evelynvaldezz/CODE-RED-controllers-sensors-portfolio/hardware/soldering_1.jpg

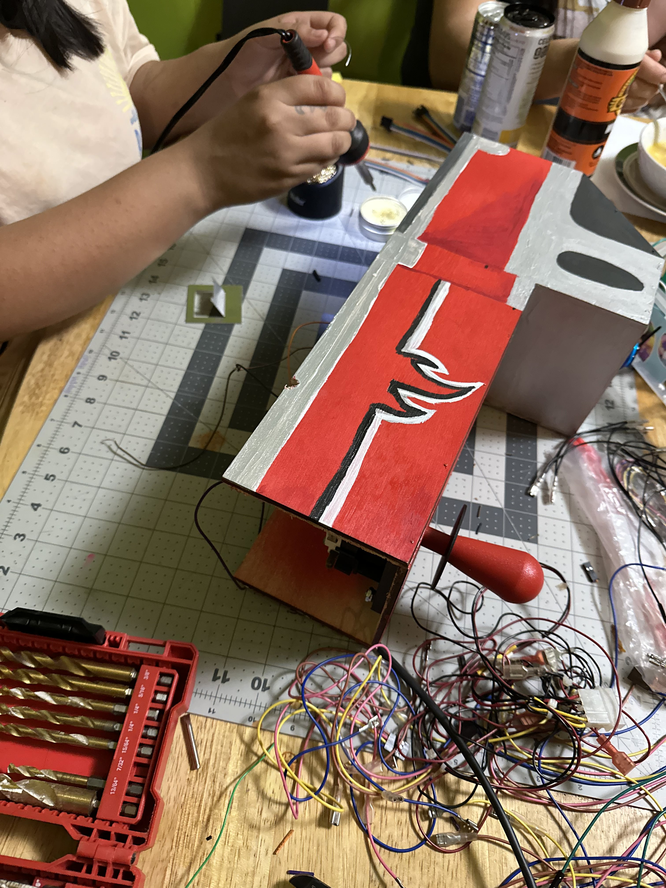
hardware/soldering_1.jpg
