evelynvaldezz/CODE-RED-controllers-sensors-portfolio/hardware/first_joystick_button_wire.PNG

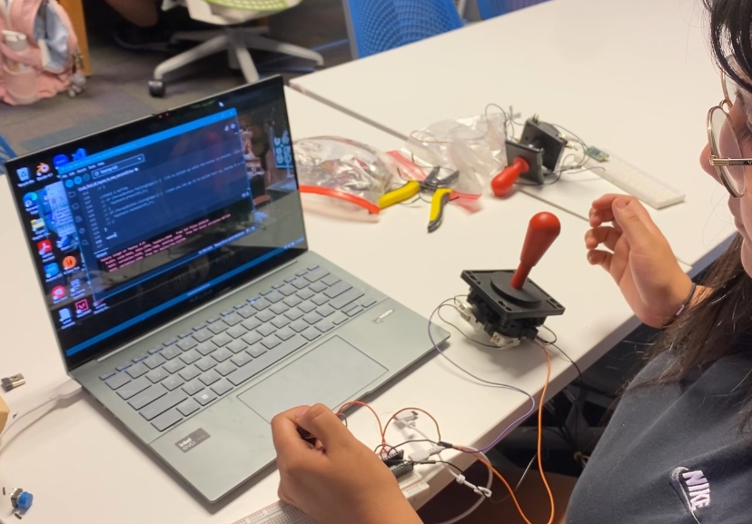
hardware/first_joystick_button_wire.PNG
