evelynvaldezz/CODE-RED-controllers-sensors-portfolio/concept/hardware_experience_concept.PNG

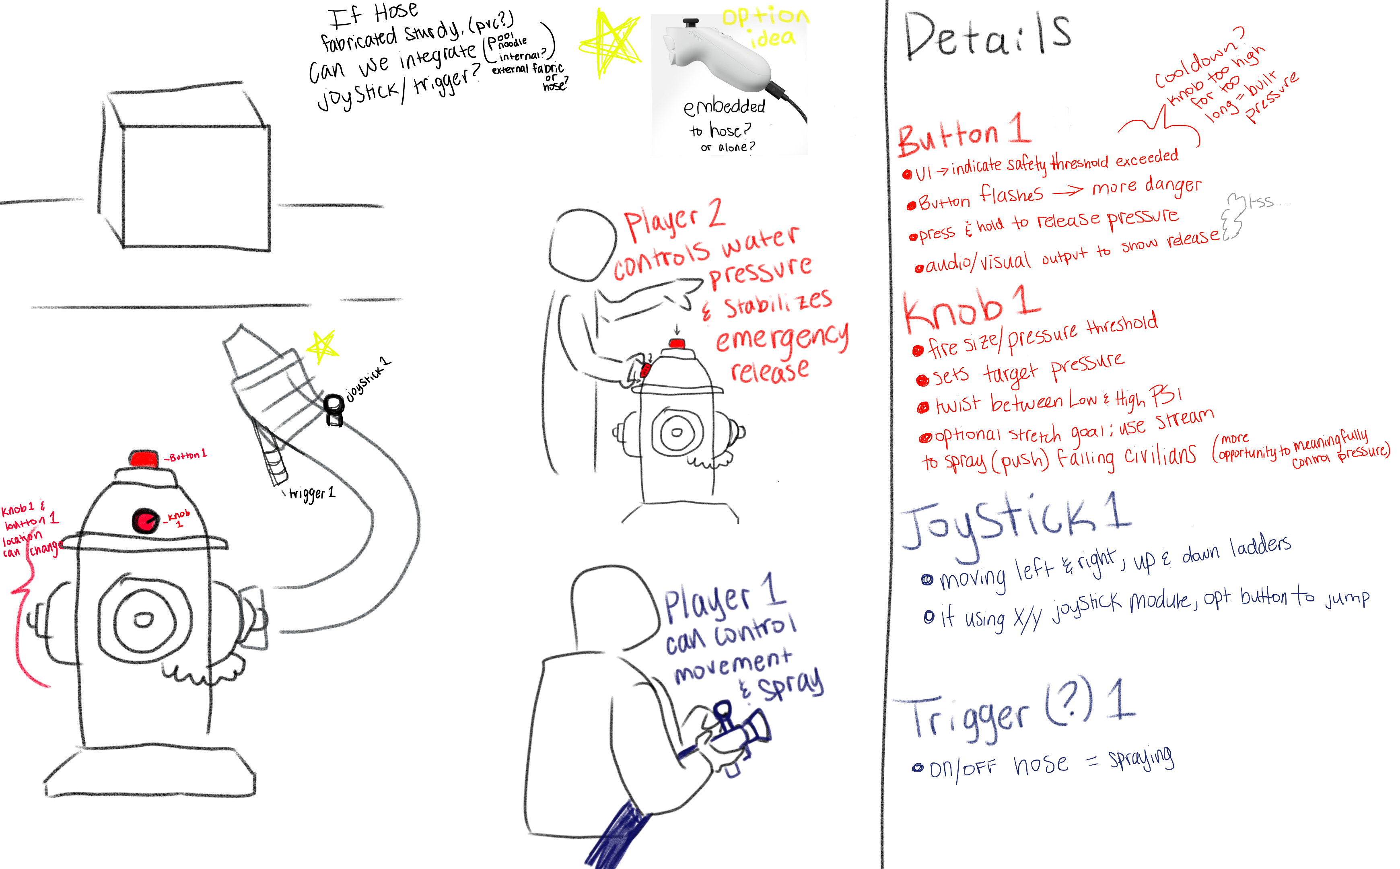
concept/hardware_experience_concept.PNG
