evelynvaldezz/CODE-RED-controllers-sensors-portfolio/concept/potentiometer_concept_.PNG

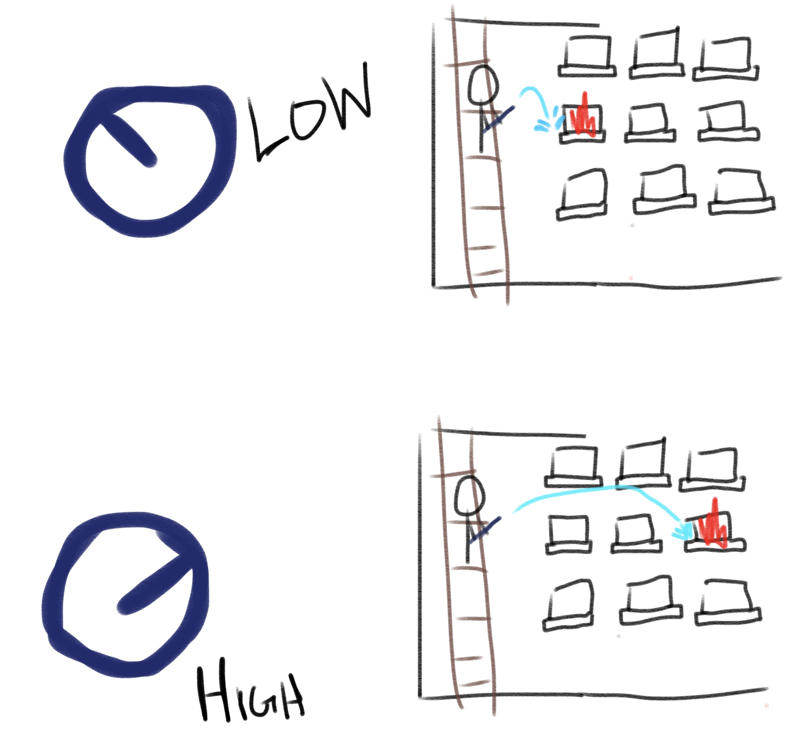
concept/potentiometer_concept_.PNG
