evelynvaldezz/CODE-RED-controllers-sensors-portfolio/diagram/final_wire_diagram.jpg

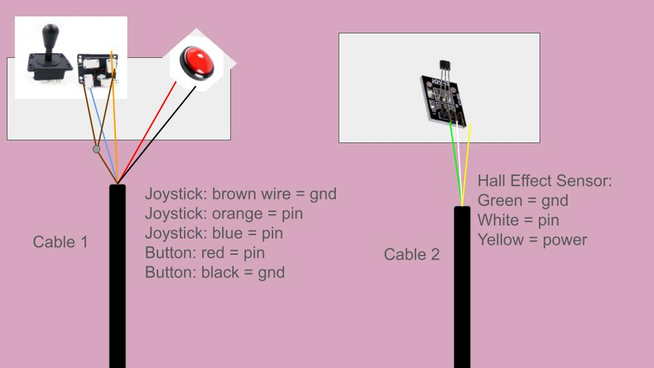
diagram/final_wire_diagram.jpg
