evelynvaldezz/CODE-RED-controllers-sensors-portfolio/diagram/first_wire_diagram.png

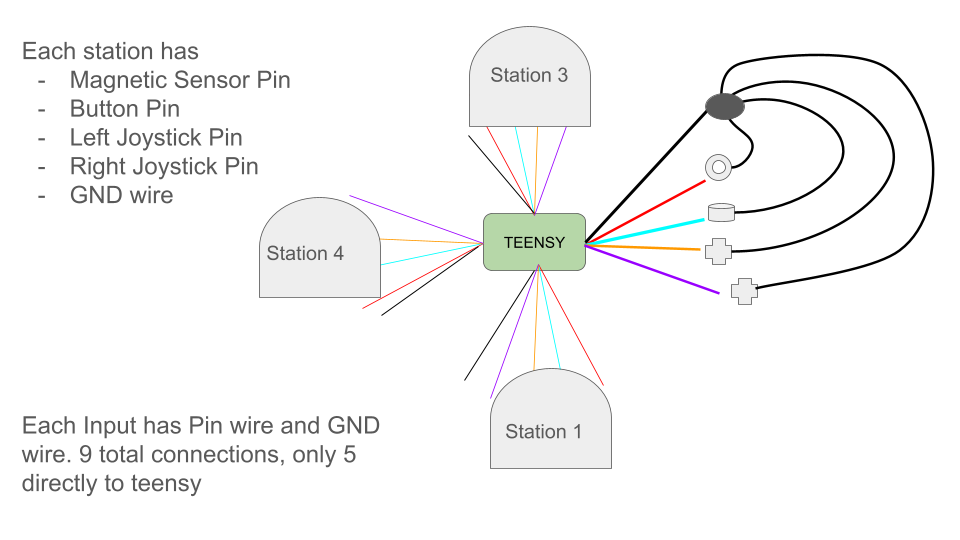
diagram/first_wire_diagram.png
