evelynvaldezz/CODE-RED-controllers-sensors-portfolio/diagram/Station_Plan.jpg

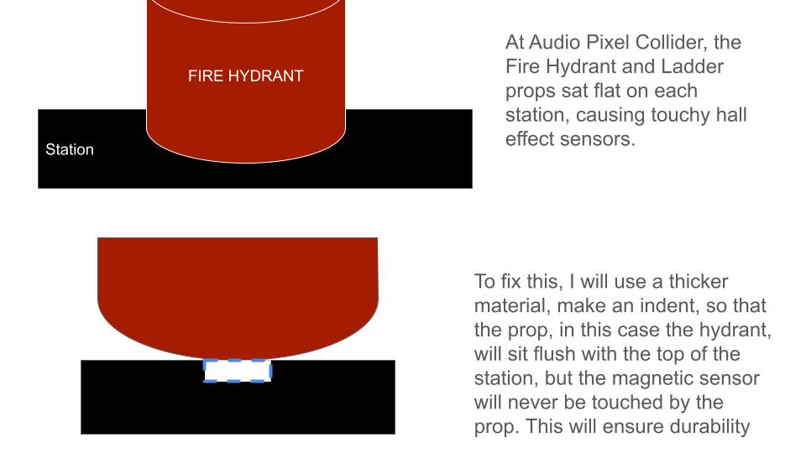
diagram/Station_Plan.jpg
