evelynvaldezz/CODE-RED-controllers-sensors-portfolio/hardware/2_controllers_props_playtesting.jpg

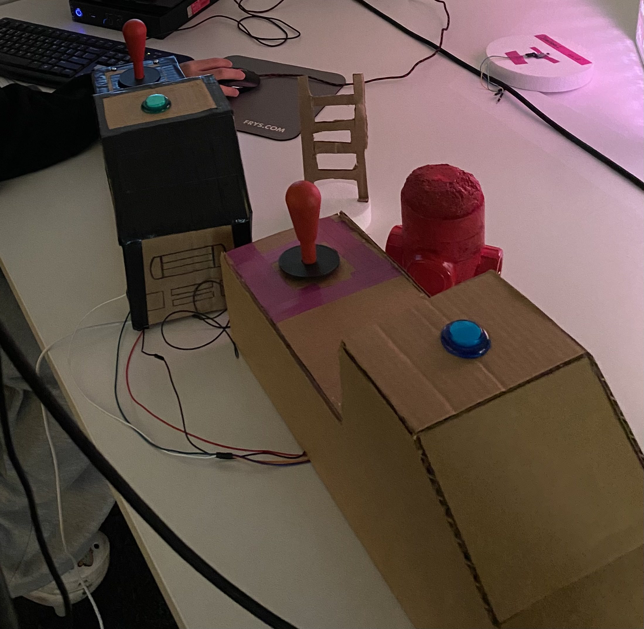
hardware/2_controllers_props_playtesting.jpg
