evelynvaldezz/CODE-RED-controllers-sensors-portfolio/hardware/first_wire_internalview.jpg

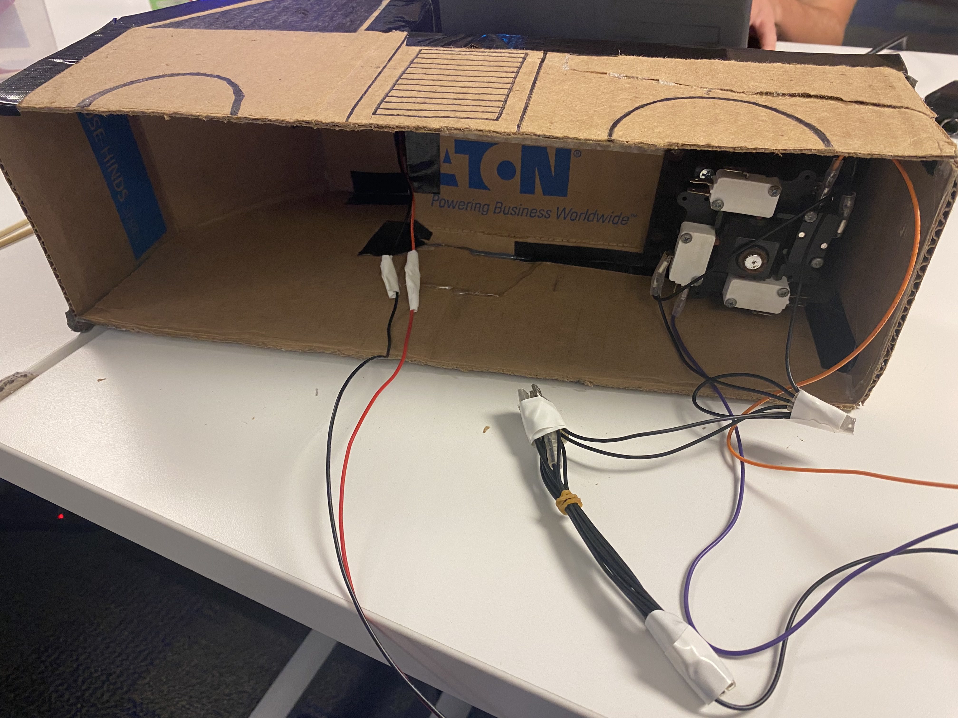
hardware/first_wire_internalview.jpg
