evelynvaldezz/CODE-RED-controllers-sensors-portfolio/hardware/first_wire_teensyview.jpg

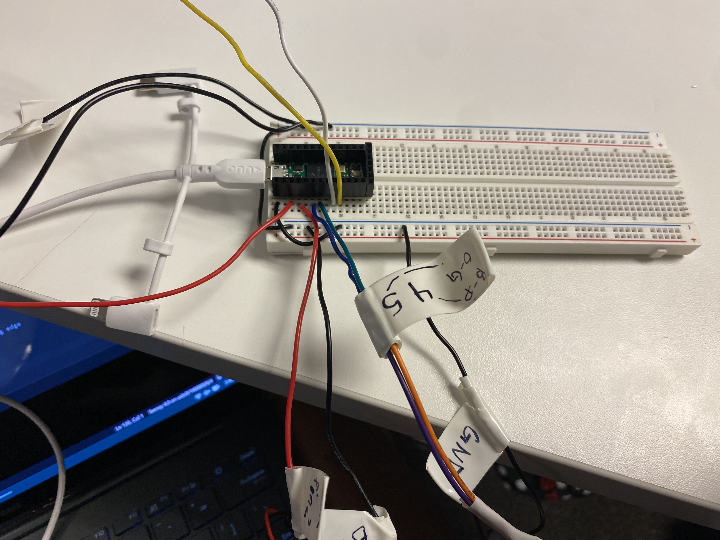
hardware/first_wire_teensyview.jpg
