evelynvaldezz/CODE-RED-controllers-sensors-portfolio/images/Blue_station.jpg

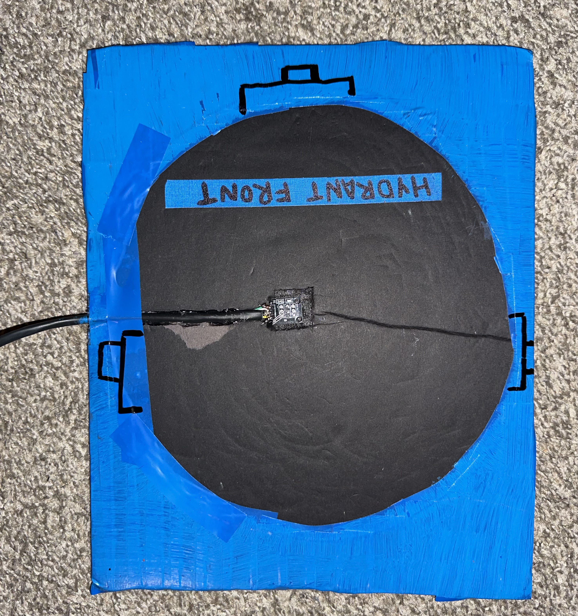
images/Blue_station.jpg
