evelynvaldezz/CODE-RED-controllers-sensors-portfolio/images/firetruck_final.jpg

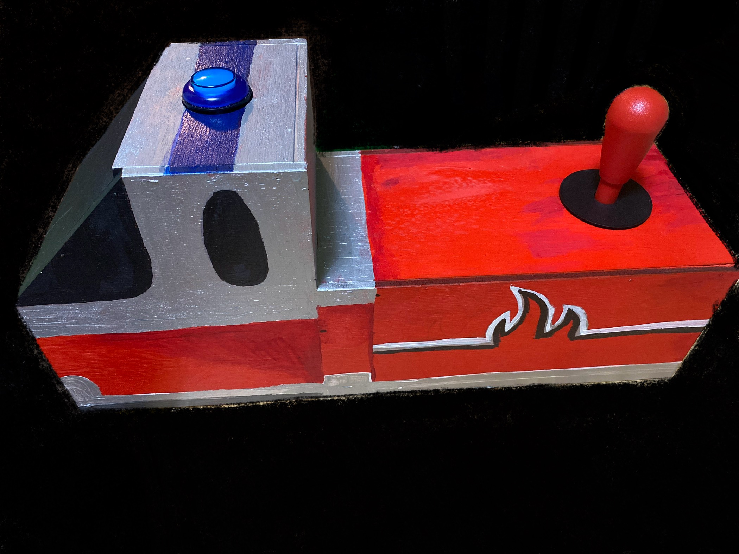
images/firetruck_final.jpg
