evelynvaldezz/CODE-RED-controllers-sensors-portfolio/images/prop_station_prototype.JPG

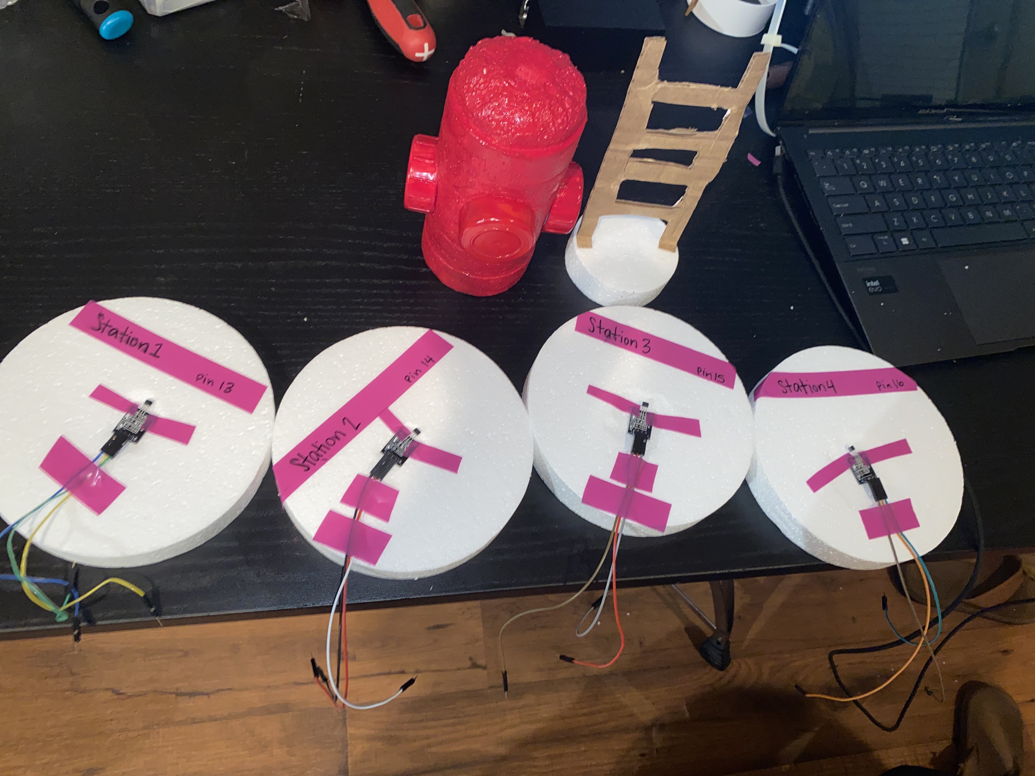
images/prop_station_prototype.JPG
