evelynvaldezz/CODE-RED-controllers-sensors-portfolio/images/props_truck_apc.PNG

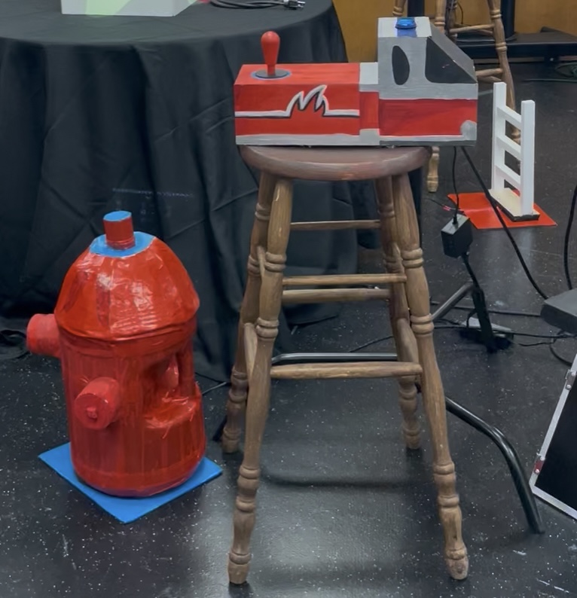
images/props_truck_apc.PNG
