evelynvaldezz/CODE-RED-controllers-sensors-portfolio/images/red_station.jpg

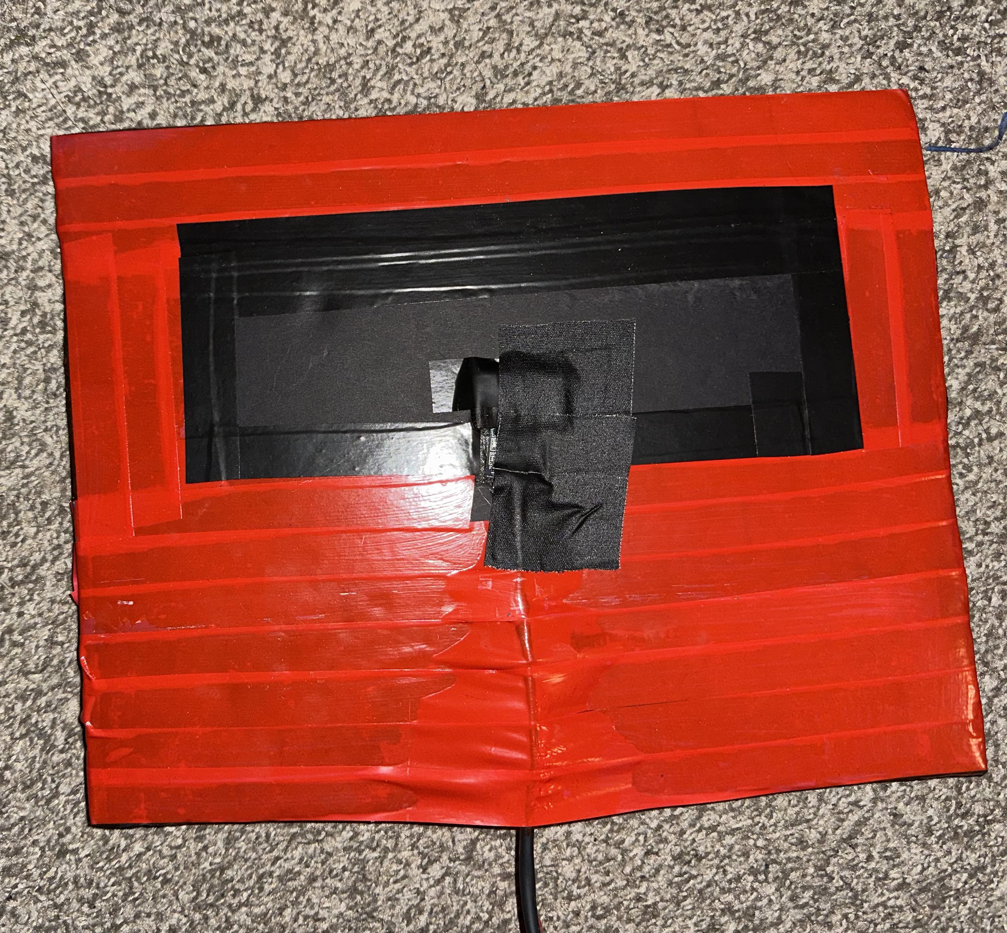
images/red_station.jpg
