evelynvaldezz/CODE-RED-controllers-sensors-portfolio/hardware/finished_wiringcable.jpg

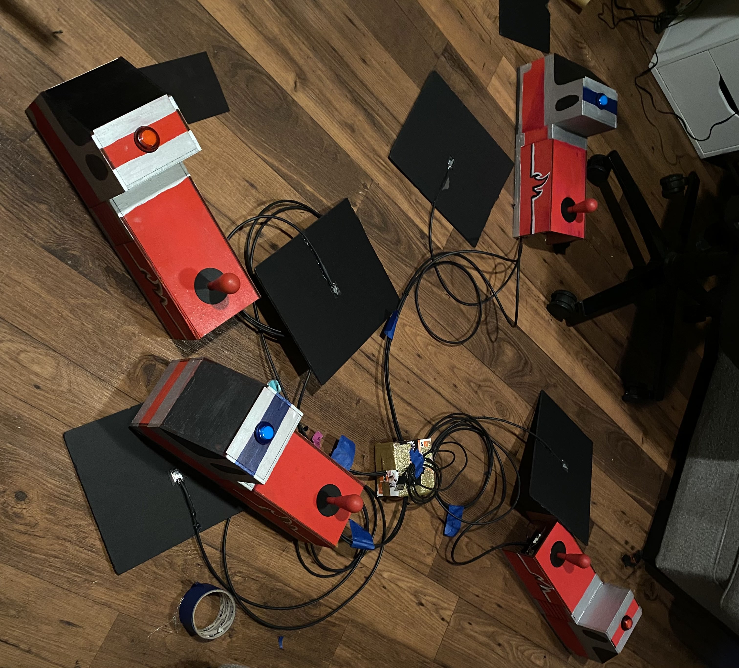
hardware/finished_wiringcable.jpg
