evelynvaldezz/CODE-RED-controllers-sensors-portfolio/hardware/button_notfitting.JPG

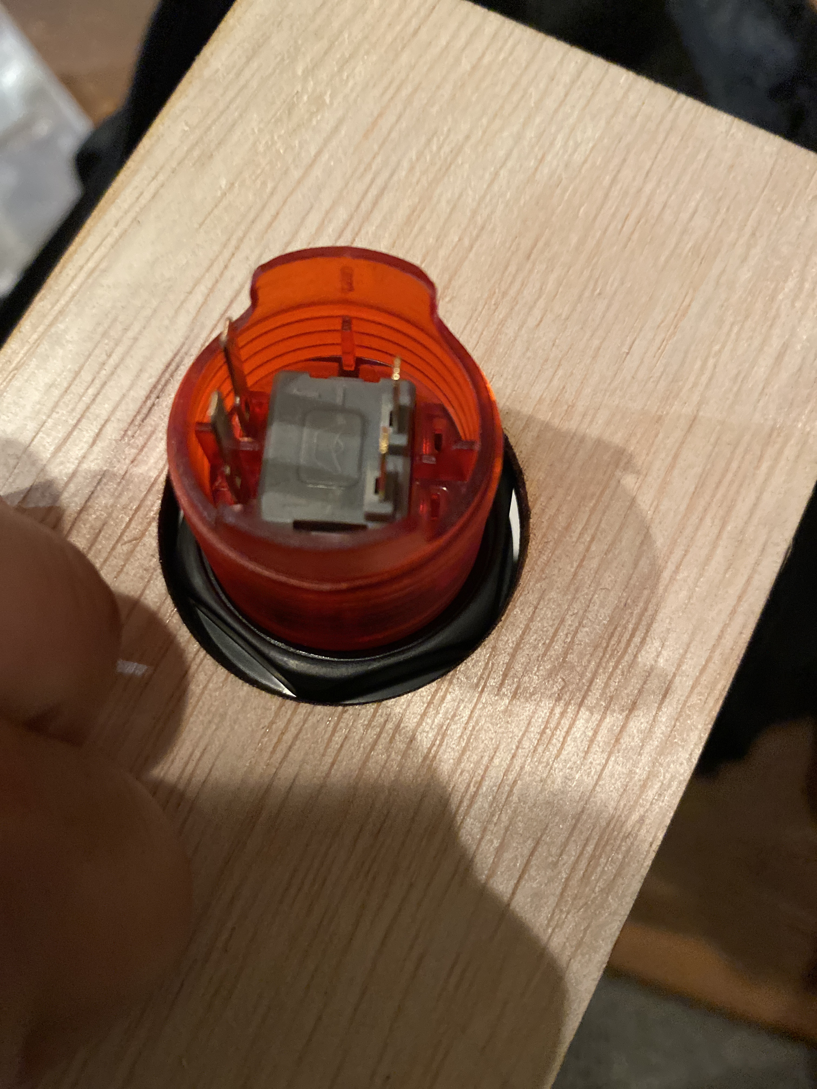
hardware/button_notfitting.JPG
