evelynvaldezz/CODE-RED-controllers-sensors-portfolio/hardware/teensy_backview.JPG

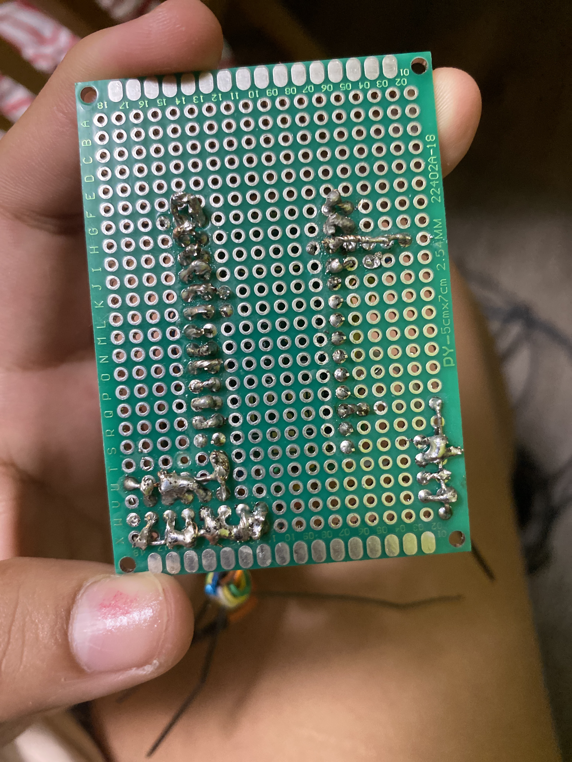
hardware/teensy_backview.JPG
